cgroupsupport/grrv/raspberry-pi/README.md

# Raspberry Pi GRRV Programs

The final version of the programs used with the Raspberry Pi during the GRRV project are in this folder.

A copy of the /etc/rc.local file used to start all the services at boot is also provided.

The folder that was used to save and run the files was the folder /home/pi/build.

A guide detailing how to setup de Wi-Fi access point is available in the wifi-interface file.
