cgroupsupport/grrv/automation/Prototypage_MCC/html/modelisation_MCC_01.png

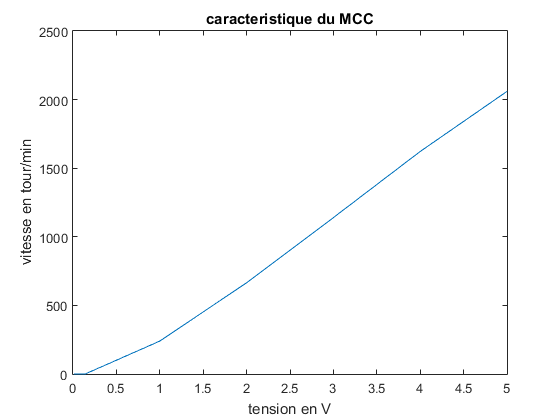
automation/Prototypage_MCC/html/modelisation_MCC_01.png
