cgroupsupport/grrv/automation/Prototypage_MCC/html/modelisation_MCC_02.png

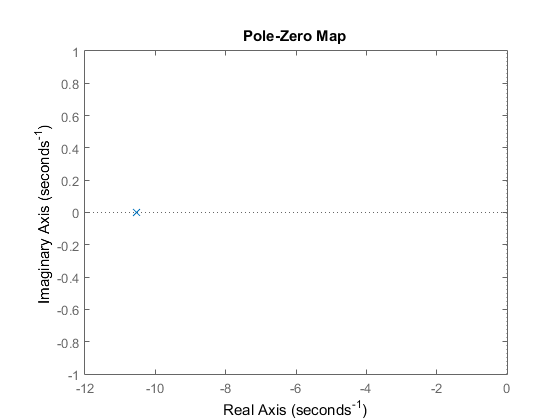
automation/Prototypage_MCC/html/modelisation_MCC_02.png
