cgroupsupport/grrv/automation/Prototypage_MCC/html/modelisation_MCC_03.png

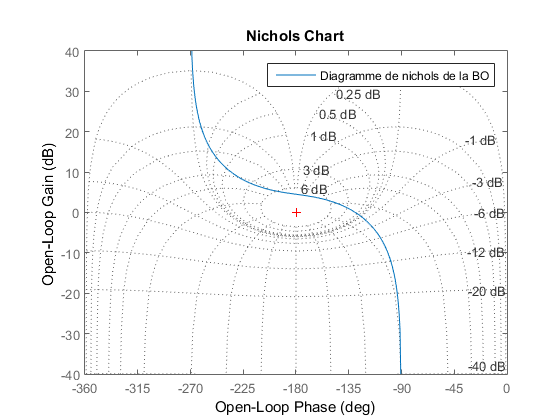
automation/Prototypage_MCC/html/modelisation_MCC_03.png
