cgroupsupport/grrv/automation/Prototypage_MCC/html/modelisation_MCC_04.png

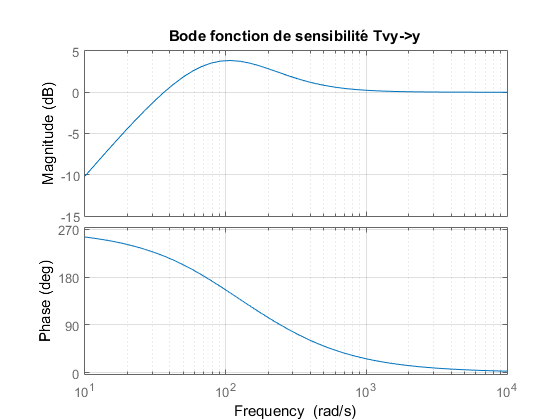
automation/Prototypage_MCC/html/modelisation_MCC_04.png
