cgroupsupport/grrv/automation/Prototypage_MCC/html/modelisation_MCC_05.png

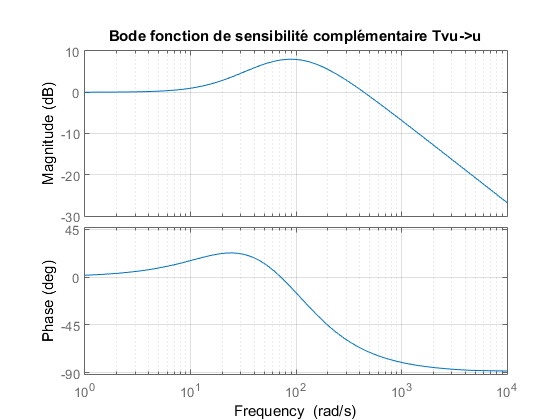
automation/Prototypage_MCC/html/modelisation_MCC_05.png
