cgroupsupport/grrv/automation/Prototypage_MCC/html/modelisation_MCC_06.png

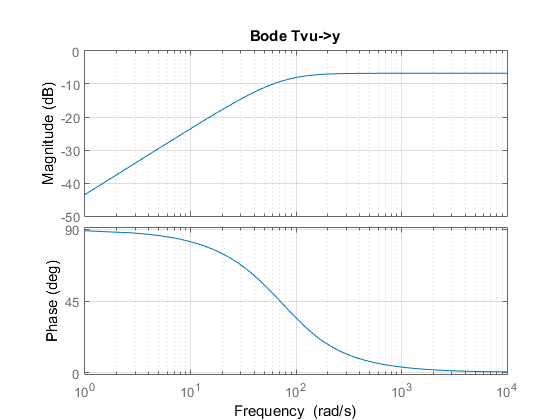
automation/Prototypage_MCC/html/modelisation_MCC_06.png
