cgroupsupport/grrv/automation/Prototypage_MCC/html/modelisation_MCC_07.png

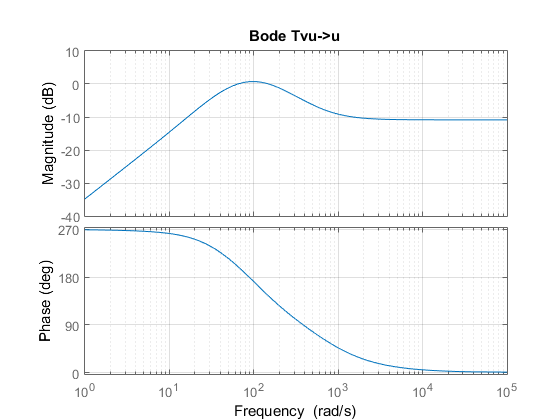
automation/Prototypage_MCC/html/modelisation_MCC_07.png
