cgroupsupport/grrv/automation/Prototypage_MCC/html/modelisation_MCC_08.png

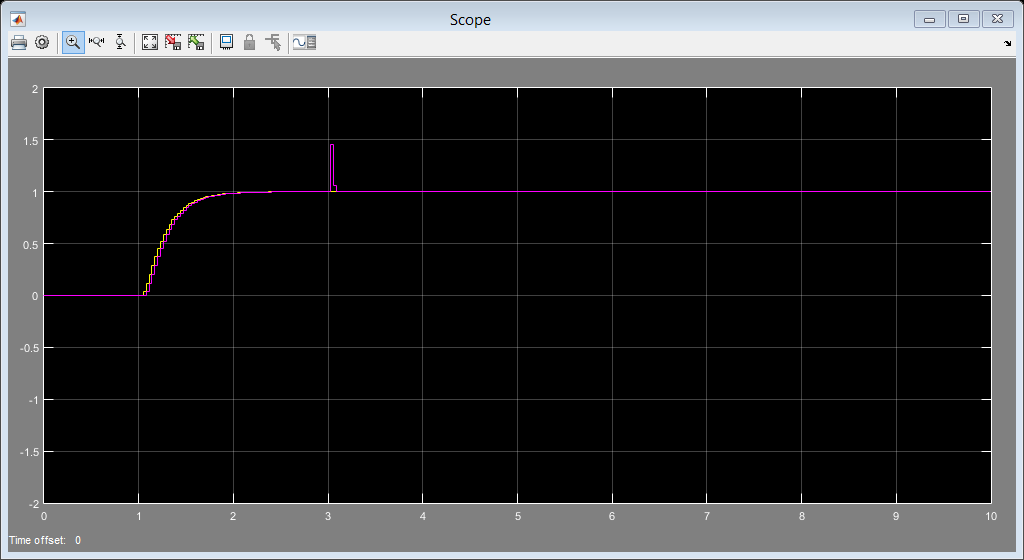
automation/Prototypage_MCC/html/modelisation_MCC_08.png
