cgroupsupport/grrv/(list of files, cad)

Other CAD files:
3d-model/Assemblage_Complet.skp
3d-model/Assemblage_Partiel.skp
3d-model/Cartes electroniques/modele_rasp.skp
3d-model/Cartes electroniques/modŠle_Puissance.skp
3d-model/Cartes electroniques/modŠle_nucl‚o.skp
3d-model/Cartes electroniques/modŠle_pcb.skp
3d-model/DESIGN/Pliage_carton Partie 1.skp
3d-model/DESIGN/Pliage_carton Partie2.skp
3d-model/DESIGN/Support_cartes.skp
3d-model/Imprimante 3D/Blocage_Translation.skp
3d-model/Imprimante 3D/Support_cam.skp
3d-model/Imprimante 3D/Support_type_U_1.skp
3d-model/Imprimante 3D/Support_type_U_2.skp
3d-model/Imprimante 3D/SystŠme vispartiecube.skp
3d-model/Imprimante 3D/blocage 2 axe_translation.skp
3d-model/SystŠmevis.skp
3d-model/modŠle support.skp
3d-model/modŠle_cam.skp
