cgroupsupport/grrv/pcb/GRRVboardCGROUP2015.brd

## EAGLE design pcb/GRRVboardCGROUP2015.brd (2015-10-06)

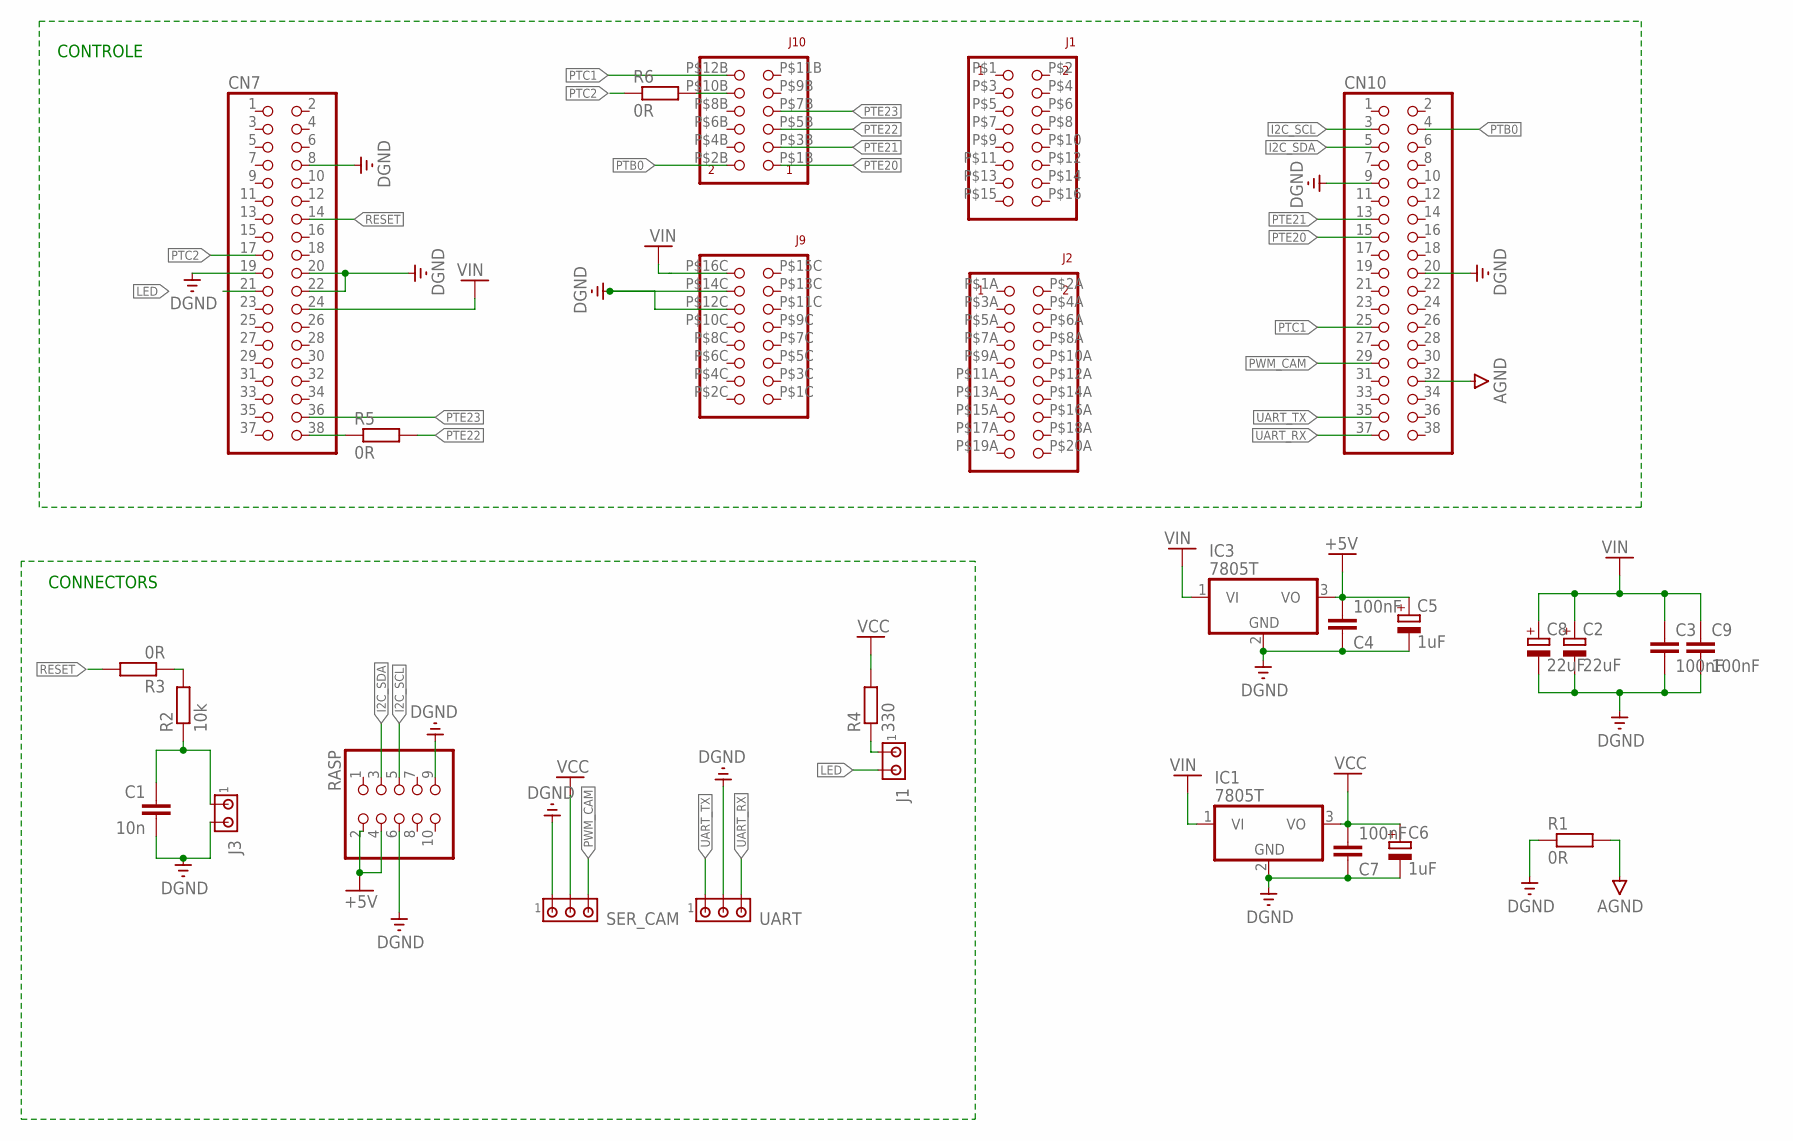
[picture p13: schematic GRRVboardCGROUP2015.sch]

Parts:
C1: 10n; C0805
C2, C8: 22uF; SMC_B
C3, C4, C7, C9: 100nF; C0805
C5, C6: 1uF; SMC_B
CN7, CN10: PINHD-2X19; 2X19
IC1, IC3: 7805T; TO220H
J1, J3: MTA02-100; 10X02MTA
R1: 0R; M1206
R2: 10k; M0805
R3, R5, R6: 0R; R0805
R4: 330; M0805
RASP: PINHD-2X5; 2X05
SER_CAM: MTA03-100; 10X03MTA
U$1: FRDM-TFC; FRDM
UART: MTA03-100; 10X03MTA

Connections:
+5V: C4.2, C5.+, IC3.3 (VO), RASP.2, RASP.4
AGND: CN10.32, R1.2
DGND: C1.2, C2.-, C3.2, C4.1, C5.-, C6.-, C7.1, C8.-, C9.2, CN7.8, CN7.19, CN7.20, CN7.22, CN10.9, CN10.20, IC1.2 (GND), IC3.2 (GND), J3.2, R1.1, RASP.6, RASP.9, SER_CAM.1, U$1.P$12C (12C), U$1.P$14C (14C), UART.2
I2C_SCL: CN10.3, RASP.5
I2C_SDA: CN10.5, RASP.3
LED: CN7.21, J1.2
unnamed: CN7.38, R5.1
unnamed: R2.2, R3.1
unnamed: J1.1, R4.1
unnamed: R6.2, U$1.P$10B (10B)
unnamed: C1.1, J3.1, R2.1
PTB0: CN10.4, U$1.P$2B (2B)
PTC1: CN10.25, U$1.P$12B (12B)
PTC2: CN7.17, R6.1
PTE20: CN10.15, U$1.P$1B (1B)
PTE21: CN10.13, U$1.P$3B (3B)
PTE22: R5.2, U$1.P$5B (5B)
PTE23: CN7.36, U$1.P$7B (7B)
PWM_CAM: CN10.29, SER_CAM.3
RESET: CN7.14, R3.2
UART_RX: CN10.37, UART.3
UART_TX: CN10.35, UART.1
VCC: C6.+, C7.2, IC1.3 (VO), R4.2, SER_CAM.2
VIN: C2.+, C3.1, C8.+, C9.1, CN7.24, IC1.1 (VI), IC3.1 (VI), U$1.P$16C (16C)

Notes on the sheet:
CONTROLE
CONNECTORS

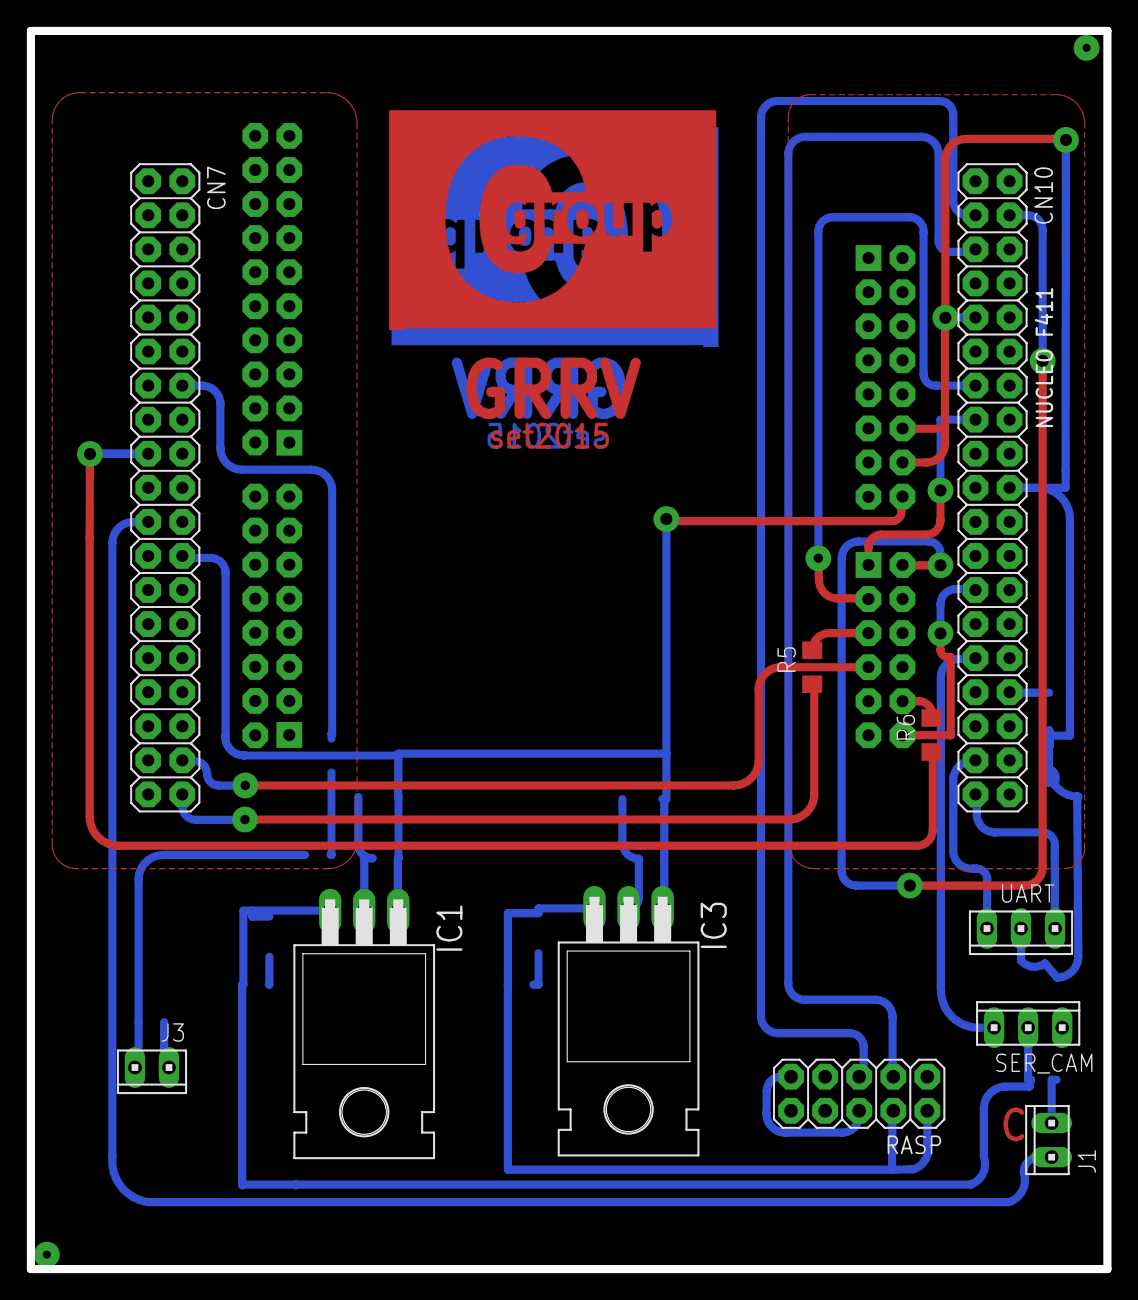
[picture p14: board GRRVboardCGROUP2015.brd from above]

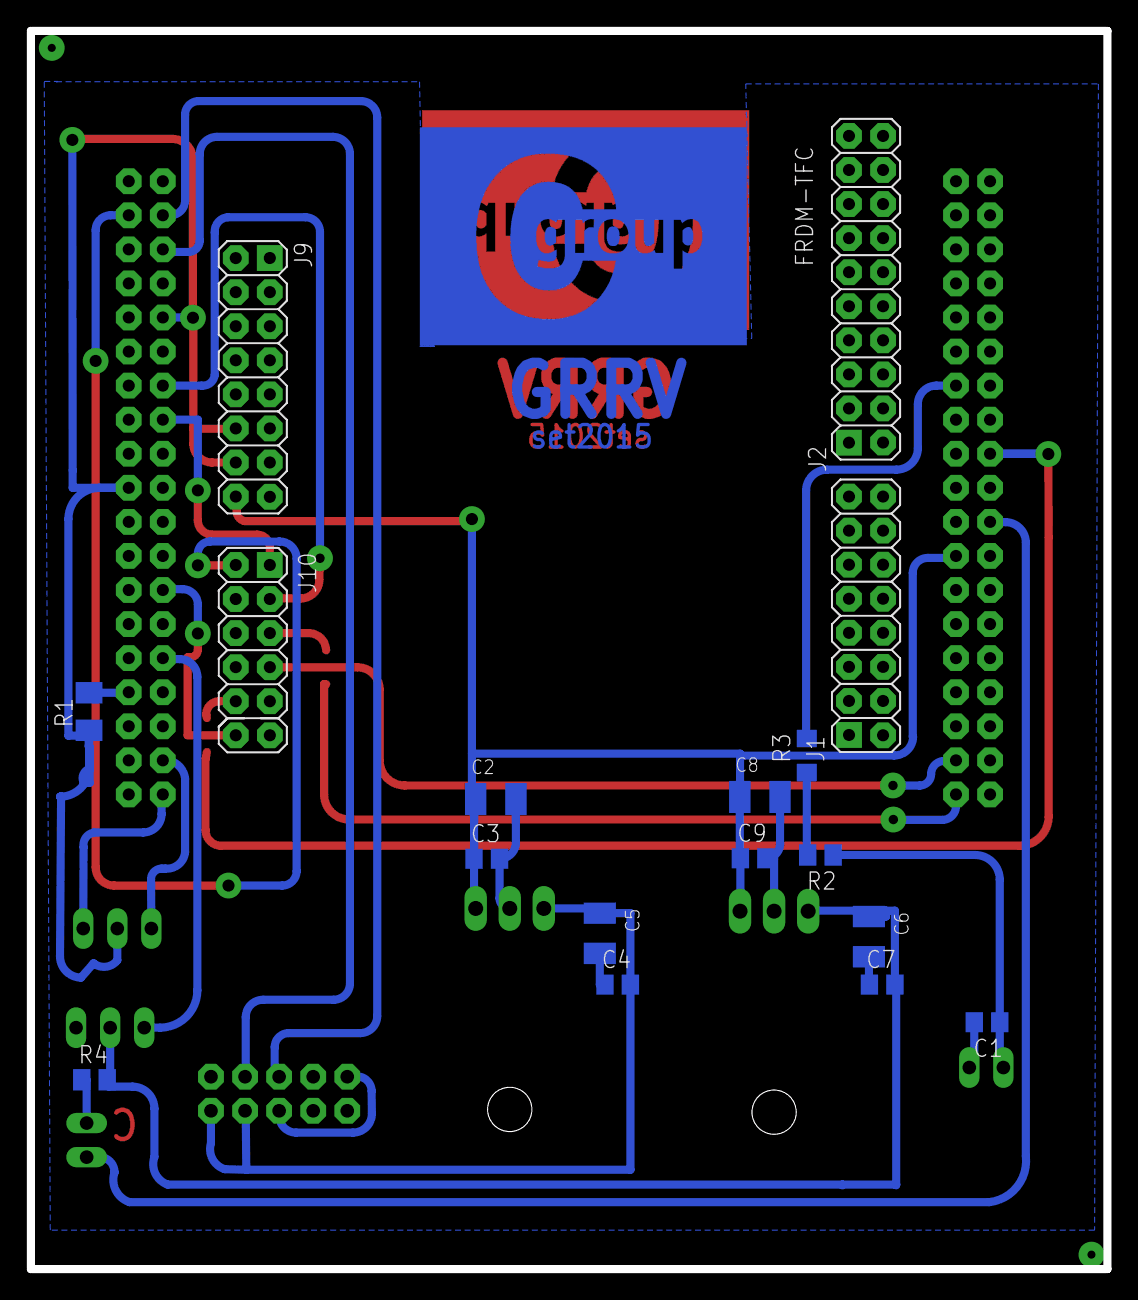
[picture p15: board GRRVboardCGROUP2015.brd from below]

Board: 2 copper layers, 80.3 x 92.3 mm, 25 parts (14 on the bottom side), 24 nets.
