cgroupsupport/grrv/rts/Projet Complet sans RTOS/Inc/uart_cgroup.h

/**
  ******************************************************************************
  * @file    uart_cgroup.h
  * @author  C group - ENSI Corp
  * @version V1.0
  * @date    01-October-2015
  * @brief   This file contains all the functions prototypes for the UART module 
  ******************************************************************************
**/

#ifndef UART_CGROUP_H
#define UART_CGROUP_H

/* Includes ------------------------------------------------------------------*/
#include "stm32f4xx_hal.h"

/* Functions -----------------------------------------------------------------*/

/**
   * @fn MX_USART2_UART_Init
   * @brief Configure the USART2
	 * @param None
   * @retval None
   */
void MX_USART2_UART_Init(void);

/**
   * @fn SendChar
   * @brief Display a letter in the Terminal
	 * @param The letter
   * @retval None
   */
void SendChar (char letter);

/**
   * @fn SendStr
   * @brief Display a String in the Terminal
	 * @param Char Buffer
   * @retval None
   */
void SendStr (char* stringToSend);

/**
   * @fn GetChar
   * @brief Recover the letter wrote by the User in the Terminal
	 * @param None
   * @retval the letter recovered
   */
char GetChar (void);

/**
   * @fn GetStr
   * @brief Store and Display the word wrote by the User in the Terminal
	 * @param The word wrote by the User
   * @retval None
   */
void GetStr(char* rxString);

/**
   * @fn terminal
   * @brief Terminal Function, interface between the User and the NUCLEO
	 * @param Word wrote by the User
   * @retval None
   */
void terminal( char * string);

#endif

/************************ C group && ENSI Corp ********************************/
